ut-robotics/picr22-team-owo/electronics/pinout documentation.xlsx

Function | Timer | Channel | Pin
M1PWM | 8 | 1 | PB0
M2PWM | 8 | 2N | PA15
M3PWM | 8 | 3N | PB5
S1PWM | 15 | 1 | PA2
S2PWM | 15 | 2 | PA3
TMPWM | 2 | 1 | PA0
ENC11 | 4 | 1 | PB6
ENC12 | 4 | 2 | PB7
ENC21 | 1 | 1 | PA8
ENC22 | 1 | 2 | PA9
ENC31 | 3 | 2 | PA4
ENC32 | 3 | 1 | PA6
INFR | x |  | PF1
M1D | x | x | PA7
M2D | x | x | PA5
M3D | x | x | PB4
MSLEEP | x | x | PB3
LED1 | x | x | PF0
LED2 | x | x | PA1
