ut-robotics/picr22-team-owo/(threads)

Thread 1 (2022-09-17):

[Mechanics] Thrower walls colliding with top plate

maidlam, 2022-09-17:
The thrower walls are colliding with the top plate.

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

Closed 2022-09-18.

Thread 2 (2022-09-17):

[Mechanics] Wall wont fit between plates

maidlam, 2022-09-17:
The part of the walls that's going to be between the plates is too big - plates distance 60,4 mm, wall 61 mm.

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

Closed 2022-09-18.

Thread 3 (2022-09-17):

[Mechanics] Thrower motor too low

maidlam, 2022-09-17:
With the current height of the motor (somewhat related to issue https://github.com/ut-robotics/picr22-team-owo/issues/1), it is low enough that it may cause issues when grabbing a ball.
The motor should slightly touch the ball when driving into it - motor height of 38 mm from the floor should be enough.

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

Closed 2022-09-18.

Thread 6 (2022-09-20):

[Mechanics] Separate inner and outer contours

maidlam, 2022-09-20:
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

I mistakenly told you to also add the inner contours of the two discs to the 2D Contour operation.
Inner and outer contours should be split up into separate operations, and inner contours should be cut first.

You can create a duplicate of the current 2D Contour, only keep the inner cuts in one, and outer cuts in the other.
Then set the order of the operations under your Setup, so that the inner contour operation is before the outer contours.

Closed 2022-09-21.

Thread 7 (2022-10-05):

[Mechanics] Add support to rollers

Akustav, 2022-10-05:
You should add side supports for rollers to stop them from wibble-wobble-ing in the slot. This also allows you to make the roller slot a little larger to avoid it getting jammed with carpet fibers.

Something like this would work:
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

Closed 2022-10-28.

Thread 8 (2022-10-05):

[Mechanics] use chamfered screws for wheel mounting

Akustav, 2022-10-05:
Would you be able to use chambered screws here? This makes 3D printing simpler, allows for more material to be around the screw and results in a flush finish. Example of the holes:

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

Closed 2022-10-28.

Thread 10 (2022-10-16):

[Mechanics] interesting spacer length

Akustav, 2022-10-16:
The middle spacers are 20.40 instead of 20.00:

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

I guess this is due to material thickness and the room provided in the test chassis. It in itself is not a huge issue, just want to clarify.

Thread 11 (2022-10-16):

[Mechanics] reduce rapid distance

Akustav, 2022-10-16:
Currently the mill might cut too fast when transferring from one contour to another:

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

Check the "Keep tool down" setting and "Safe distance" to avoid such cases.

Closed 2022-10-17.

Thread 9 (2022-10-16):

[Mechanics] move thrower back a little

Akustav, 2022-10-16:
I suggest you move the thrower back a little to make room for the thrower cable. If you move everything back a little or make it shorter there is more room in point 1.

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

Closed 2022-10-17.

Thread 12 (2022-10-17):

[Mechanics] move angle adjust servo to the back

Akustav, 2022-10-17:
I suggest moving the angle adjustment servo to the back of the thrower. When it is in the front, there is a leverage disadvantage applied to the servo. This makes it harder for the servo to maintain the angle. You could for example use a sliding connection at the back:

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

Akustav, 2022-10-28:
You currently have a lot of play in the servo horn. I suggest tightening the tolerances to avoid excessive play in the adjustment ramp.

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

Akustav, 2022-10-28:
I also guess the pin is a M3 bolt? I suggest using a tapered head screw so it looks something like this:

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

I also suggest thickening up the adjustment arm on the servo. Maybe mill it from a 4.8mm piece of PC for additional rigidity.

Closed 2022-11-08.

Thread 13 (2022-10-17):

[Mechanics] roller adjustments

Akustav, 2022-10-17:
I suggest adding a lip to the roller to reduce potential side wall friction:

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

The tolerances of the servo horn area also seem too tight. Add some room there to ease assembly and disassembly:

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

Closed 2022-10-28.

Thread 15 (2022-10-17):

[Mechanics] consider adding a place for a light gate sensor

Akustav, 2022-10-17:
Currently I can not see a place for a light gate sensor. This sensor allows you to detect when a ball has been grabbed deep enough. It can be hard to detect via the camera. It can be somewhere like here (discuss in team as to where you want it to be):

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

Akustav, 2022-10-28:
Is there any way of fastening the sensor and LED? I currently see no way.

Closed 2022-11-08.

Thread 16 (2022-10-17):

[Mechanics] make thrower cable hole bigger

Akustav, 2022-10-17:
Not a big deal but I suggest making the cable hole for the thrower bigger to make cable routing simpler. The 3.5mm bullets and cables can take a lot of room and can be a pain to get through small slots.

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

Closed 2022-10-28.

Thread 20 (2022-10-26):

MCU pin assignement

ReikoR, 2022-10-26:
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

I could not find working pin usage for the MCU.

Can you explain how the timer channels are used?

Most important part is that PWM outputs can't be properly used on timers that have encoder mode enabled, as in encoder mode the counter value is changed based on encoder inputs.

dakoko, 2022-10-29:
I was unaware of the encoder mode and PWM output conflict. I changed the timers and pins around so that they'd be seperated from now on (new and old timer/pinout/channel setup is brought out in the pinout documentation spreadsheet file).

Timers 1, 3 and 4 are set to encoder mode. Timer 2 handles the thrower motor PWM, timer 8 the 3 motor PWMs and time 15 the servo PWMs.

For this fix I had to sacrifice the PWM input meant for the opto sensor and was replaced with an ADC. I will most likely handle the smoothing and other possible complications offboard.

ReikoR, 2022-10-30:
For optical sensor it's probably best to use EXTI (external interrupt) as the sensor output is digital.
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

Otherwise new pin assignment might work.

Closed 2022-10-30.

Thread 22 (2022-10-26):

Add decoupling capacitors to all MCU power pins

ReikoR, 2022-10-26:
There are currently 2 sets of decoupling capacitors:
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

But 3 power pins (2x VDD, 1x VDDA):
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

dakoko, 2022-10-29:
Added another set of decoupling capacitors for the MCU

Closed 2022-10-30.

Thread 23 (2022-10-28):

[Mechanics] why not use conical screws?

Akustav, 2022-10-28:
Is there a reason you avoid conical screws? They tend to weaken the components less when attaching them. They just need some countersinking to work. We have a specific drill for that. Number one is the conical counter sink, compared to approach on number 2.

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

Closed 2022-11-08.

Thread 24 (2022-10-28):

[Mechanics] move spacers in for ramp

Akustav, 2022-10-28:
I suggest moving the spacer for the internal ramp a little forward or replace one spacer with two. Since the ramp is quite long, it can bend and increase variation in ball grabbing:

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

Closed 2022-11-08.

Thread 25 (2022-10-30):

Overlapping schematic objects

ReikoR, 2022-10-30:
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

dakoko, 2022-10-31:
Fixed the overlap on the schematic

ReikoR, 2022-11-02:
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

dakoko, 2022-11-02:
Fixed the overlap for c14

Closed 2022-11-06.

Thread 27 (2022-10-30):

Incorrect isolator pinout

ReikoR, 2022-10-30:
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

Right side pin numbers are in reverse order.

Correct pinout:
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

dakoko, 2022-10-31:
Fixed the isolator pinout and rerouted things accordingly

ReikoR, 2022-11-06:
Some pins are still incorrect:
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

dakoko, 2022-11-06:
Fixed the power pin order.

Closed 2022-11-09.

Thread 28 (2022-10-30):

DRVOFF does not need to be connected to MCU

ReikoR, 2022-10-30:
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

DRVOFF can be connected to GND to keep motor driver constantly enabled.

This would allow to free up one isolator pin and allow to use smaller 2-channel isolator.

dakoko, 2022-10-31:
Removed the DRVOFF pin connections, however I still argue for having 3 4-channel isolators as three of the outputs are needed at the top of the board. Replacing it with a 2 channel isolator would needlessly lengthen the signal traces (and also cut into the copperless area inbetween the isolated grounds).

Closed 2022-11-09.

Thread 30 (2022-11-05):

[Mechanics] Camera mount issues

maidlam, 2022-11-05:
1. Add bolts to both sides of the middle support.
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

2. Add bolts to both sides of the camera mount crossbeam.
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

3. Faulty tenon for camera mount and bottom plate.
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

Closed 2022-11-16.

Thread 32 (2022-11-06):

PA1 pin used for ball sensor is not 5V tolerant

ReikoR, 2022-11-06:
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

From [datasheet](https://www.st.com/resource/en/datasheet/stm32g441kb.pdf):
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

dakoko, 2022-11-06:
The output signal of the ball sensor is going to be brought down to 3.3v with the offboard electronics needed for the sensor. Most likely through a voltage divider.

ReikoR, 2022-11-06:
It would be easier to use one of the 5V tolerant pins. For example PF0 or PF1:
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

dakoko, 2022-11-06:
Switched the signal led pin (PF1) with the ball sensor pin (PA1)

Thread 34 (2022-11-06):

Use wider motor driver output connections

ReikoR, 2022-11-06:
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

Polygons can be used:
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

Pads could also be placed right next to the drivers:
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

dakoko, 2022-11-06:
Placed the pads next to the drivers and rerouted traces to create less dead copper.

Closed 2022-11-09.

Thread 36 (2022-11-09):

Avoid routing tracks next to each other

ReikoR, 2022-11-09:
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

Signals from one track will couple into adjacent tracks and cause noise.

dakoko, 2022-11-09:
Dismantled the buses, most have significantly more room between them now.

ReikoR, 2022-11-09:
Still some improvements that could be made:

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

dakoko, 2022-11-10:
Followed the suggested improvements.

Closed 2022-11-10.

Thread 37 (2022-11-09):

Place GND vias close to components

ReikoR, 2022-11-09:
For example:
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

dakoko, 2022-11-09:
Added lots of vias.

ReikoR, 2022-11-09:
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

dakoko, 2022-11-09:
Suggested locations are directly above 2 power rails, is it really worth putting a hole through VBAT?
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

ReikoR, 2022-11-10:
5V track can be moved. Having it next to VBAT is not good anyway.

Something like this:
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

dakoko, 2022-11-10:
Moved the trace

Closed 2022-11-10.

Thread 38 (2022-11-09):

LEDs at the bottom

ReikoR, 2022-11-09:
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

Not sure how you will attach the PCB to the robot, but LEDs might not be visible on the robot or even off the robot.

dakoko, 2022-11-09:
These LEDs will be used for firmware debugging with an open robot where the PCB isn't attached.

Closed 2022-11-09.

Thread 39 (2022-11-09):

Route USB data signals as differential pair

ReikoR, 2022-11-09:
More information here:
https://github.com/ut-robotics/picr22-team-gibibot/issues/32

But use JLC7628 stackup as it is cheaper.

For example 8 mil (about 0.2 mm) trace space and 10.28 mil (about 0.26 mm) trace width would work:
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

dakoko, 2022-11-10:
Rerouted the USB data signals to comply with these rules

Closed 2022-11-10.

Thread 40 (2022-11-09):

Create Gerber X2 files

ReikoR, 2022-11-09:
Create Gerber X2 layer and drill files and commit them to repository for ordering the manufacturing.

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

dakoko, 2022-11-10:
Added the gerber files

dakoko, 2022-11-10:
Added the updated files

ReikoR, 2022-11-10:
Add *.gbr files also.

dakoko, 2022-11-11:
Added the gerber files, i didn't notice that the output folder wasn't included

dakoko, 2022-11-11:
Added fresh files

Closed 2022-11-11.

Thread 41 (2022-11-09):

Improve switching regulator layout

ReikoR, 2022-11-09:
Try to follow guidelines in the [TPS62933 datasheet](https://www.ti.com/lit/ds/symlink/tps62933.pdf) under 12.1 Layout Guidelines.

1. C6 capacitor should be at the output:
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

2. VIN and GND connections should be wider and with more vias.
\
From datasheet:
The VIN and GND traces must be as wide as possible and provide sufficient vias on them to minimize trace impedance. The wide areas are also of advantage from the view point of heat dissipation.
\
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

3. SW connection should be wider.
\
From datasheet:
Keep the SW trace as physically short and wide as practical to minimize radiated emissions.
\
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

4. Route feedback trace further away from the switching trace. In the current layout it's hard to route it through bottom layer, but it can be routed a bit farther from the inductor. It should also connect to output capacitors.
\
From datasheet:
Place the voltage feedback loop away from the high-voltage switching trace. The voltage feedback loop preferably has ground shield.
\
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

dakoko, 2022-11-10:
Alleviated the issues, don't know if it's enough though.

ReikoR, 2022-11-10:
It's possible to make SW copper a bit wider by moving the regulator downwards.

Before:
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

After:
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

I recommend using Polygon Pour instead of Region. Polygons automatically pour based on the rules.

Polygons:
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

Regulator input GND polygon properties:
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

I created a Polygon Connect Style rule to use direct connection for these polygons:
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
`InNet('NetC13_1') or InNet('VBAT') or ((ObjectKind = 'Poly') And (Name = 'GND_SWREG_IN')) `

Pour order also needs to be changed in Polygon Manager (Tools -> Polygon Pours -> Polygon Manager):
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
Smaller polygons need to poured before larger GND polygon.

dakoko, 2022-11-10:
Replaced the regions with pours

ReikoR, 2022-11-10:
There are very thin gaps next to the GND polygon:
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

dakoko, 2022-11-11:
Added thermal relief and fixed the thin gap issue

ReikoR, 2022-11-11:
It would be better to have GND directly connected.

dakoko, 2022-11-11:
Connected it directly

Closed 2022-11-11.

Thread 45 (2022-11-13):

[Mechanics] Tight area for step up converter cables

Akustav, 2022-11-13:
There seems to be not too much room for the throwers step up converter cabling. Is this intentional?

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

Closed 2022-11-16.

Thread 46 (2022-11-13):

[Mechanics] camera mount interlocks with top plate

Akustav, 2022-11-13:
A question about the top plate - camera mount interface.

Why should they lock in with each other? Would it not increase assembly complexity by a lot? Are there any benefits to doing it compared to not doing it?

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

Rxsengxn, 2022-11-17:
Yes it does increase assembly complexity but not that much. During first assembly, it is needed to slide them through top plate and lock them, that's all the increased complexity. After the assembly, when it's needed to get inside the robot, only the bottom plate camera mount screws need to be unscrewed in addition to other common part's screws for it to come off.

Closed 2022-11-19.

Thread 48 (2022-11-13):

[Mechanics] suggest hollowing out some of the "Kate" elements

Akustav, 2022-11-13:
I suggest to hollow out some elements of the component "Kate" so it has some room to deform when you push it in. Something like this maybe:

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

maidlam, 2022-11-16:
I think Allan meant you leave the sides intact, but cut out the center, so the sides deform inward when the part is pressed in - a reverse of the current part.
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

Thread 49 (2022-11-13):

[Mechanics] different screw holes

Akustav, 2022-11-13:
Is it intentional to have different hole styles in the same area?

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

Akustav, 2022-11-13:
Same here:

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

Rxsengxn, 2022-11-17:
These are somewhat intentional, yes. In general we used cone-shaped screws where really needed, and cylinder, where it doesn't matter that much. We could make them all cones if needed

Closed 2022-11-19.
