ut-robotics/picr22-team-owo/electronics/picr22-team-owo-mainboard/picr22-team-owo-mainboard.pdf

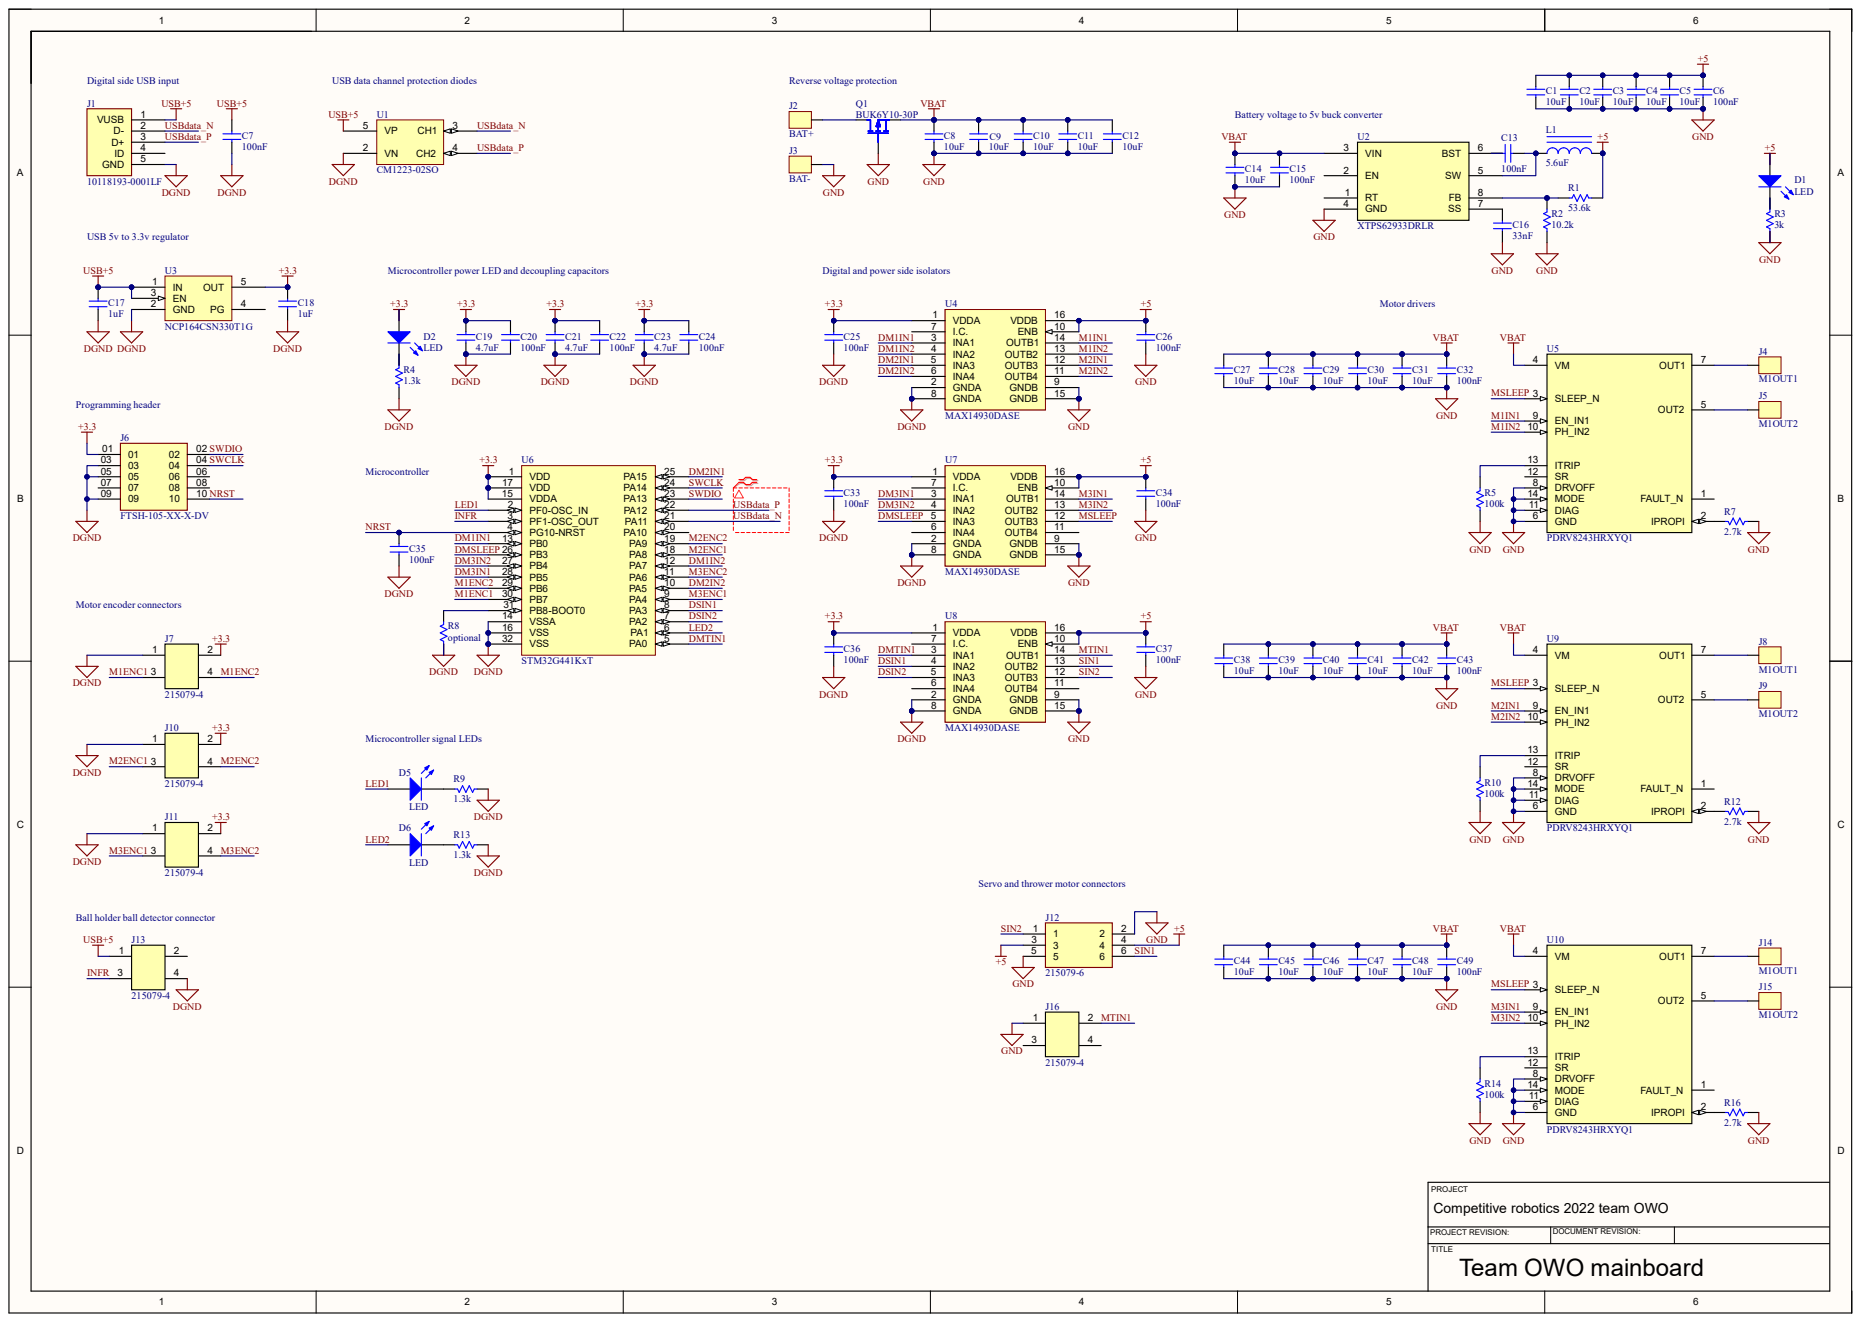
[picture p11: page 1]

Digital side USB input

USB data channel protection diodes

Battery voltage to 5v buck converter

Microcontroller power LED and decoupling capacitors

Digital and power side isolators

Servo and thrower motor connectors

Ball holder ball detector connector

PROJECT
Competitive robotics 2022 team OWO
