ut-robotics/picr22-team-owo/(list of files, drawings)

Other design files:
electronics/picr22-team-owo-mainboard/picr22-team-owo-mainboard-lib.PcbLib
electronics/picr22-team-owo-mainboard/picr22-team-owo-mainboard-lib.SchLib
electronics/picr22-team-owo-mainboard/picr22-team-owo-mainboard.PcbDoc
electronics/picr22-team-owo-mainboard/picr22-team-owo-mainboard.PrjPcb
electronics/picr22-team-owo-mainboard/picr22-team-owo-mainboard.SchDoc
