ut-robotics/picr22-team-owo/firmware/picr22-team-OWO/picr22-team-OWO.ioc

Mcu.UserName=STM32G441KBTx
PA0.GPIO_Label=TMPWM
PA0.Signal=S_TIM2_CH1
PA1.GPIO_Label=LED2
PA1.Signal=GPIO_Output
PA11.Signal=USB_DM
PA12.Signal=USB_DP
PA13.Signal=SYS_JTMS-SWDIO
PA14.Signal=SYS_JTCK-SWCLK
PA15.GPIO_Label=M2PWM
PA15.Signal=S_TIM8_CH1
PA2.GPIO_Label=S1PWM
PA2.Signal=S_TIM15_CH1
PA3.GPIO_Label=S2PWM
PA3.Signal=S_TIM15_CH2
PA4.GPIO_Label=ENC31
PA4.Signal=S_TIM3_CH2
PA5.GPIO_Label=M2D
PA5.Signal=GPIO_Output
PA6.GPIO_Label=ENC32
PA6.Signal=S_TIM3_CH1
PA7.GPIO_Label=M1D
PA7.Signal=GPIO_Output
PA8.GPIO_Label=ENC21
PA8.Signal=S_TIM1_CH1
PA9.GPIO_Label=ENC22
PA9.Signal=S_TIM1_CH2
PB0.GPIO_Label=M1PWM
PB0.Signal=TIM8_CH2N
PB3.GPIO_Label=MSLEEP
PB3.Signal=GPIO_Output
PB4.GPIO_Label=M3D
PB4.Signal=GPIO_Output
PB5.GPIO_Label=M3PWM
PB5.Signal=TIM8_CH3N
PB6.GPIO_Label=ENC11
PB6.Signal=S_TIM4_CH1
PB7.GPIO_Label=ENC12
PB7.Signal=S_TIM4_CH2
PF0-OSC_IN.GPIO_Label=LED1
PF0-OSC_IN.Signal=GPIO_Output
PF1-OSC_OUT.GPIO_Label=INFR
PF1-OSC_OUT.Signal=GPIO_Input
