ut-robotics/picr22-team-owo/firmware/picr22-team-OWO/Core/Src/main.c

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
/* Includes ------------------------------------------------------------------*/
#include "main.h"
#include "usb_device.h"

/* USER CODE BEGIN Includes */
#include "usbd_cdc_if.h" // (1)
/* USER CODE END Includes */

TIM_HandleTypeDef htim1;
TIM_HandleTypeDef htim2;
TIM_HandleTypeDef htim3;
TIM_HandleTypeDef htim4;
TIM_HandleTypeDef htim6;
TIM_HandleTypeDef htim8;
TIM_HandleTypeDef htim15;

void SystemClock_Config(void);
static void MX_GPIO_Init(void);
static void MX_TIM2_Init(void);
static void MX_TIM3_Init(void);
static void MX_TIM1_Init(void);
static void MX_TIM4_Init(void);
static void MX_TIM8_Init(void);
static void MX_TIM15_Init(void);
static void MX_TIM6_Init(void);
/* USER CODE BEGIN 0 */
typedef struct Motor_Status {
	uint16_t target_speed; // in encoder units
	uint8_t direction; // 1 = forward, 0 = backward
	int16_t enc_pos; // current encoder position
	int16_t enc_change; // Change of the encoder, currently used for debugging purposes
	int16_t integral; // PID stuff borrowed from kurgimopeed
	int16_t flat_const;
	int16_t int_const;
	int16_t der_const;
	int16_t error;
} Motor_Status;

typedef struct Command {
  int16_t speed[3]; // array of all of the motor speeds, CURRENTLY int16_t DUE TO TESTING WITH RAW MOTOR VALUES, MOVE BACK TO int8_t
  uint16_t thrower_speed; // thrower motor speed
  uint16_t servo1;
  uint16_t servo2;
  int16_t int_const;
  int16_t flat_const;
  int16_t der_const;
  uint16_t delimiter;
} Command;

typedef struct Feedback {
  int16_t speed[3];
  int16_t change[3];
  int16_t error[3];
  int16_t integral[3];
  uint16_t ball_detected;
} Feedback;

// Motor structs for all 3 motors
Motor_Status motor_status[3] = {0};

// Prefilled command struct
Command command = {.speed[0] = 0,
				   .speed[1] = 0,
				   .speed[2] = 0,
				   .thrower_speed = 3277,
				   .servo1 = 4875,
				   .servo2 = 6150,
				   .flat_const = 1,
				   .int_const = 0.1,
				   .delimiter = 0};

volatile uint8_t isCommandReceived = 0;
volatile uint16_t commandless_count = 0;

uint16_t clamp_u16(uint16_t value, uint16_t min, uint16_t max) {
	if (value > max) {return max;}
	else if (value < min) {return min;}
	return value;
}

int16_t clamp_16(int16_t value, int16_t min, int16_t max) {
	if (value > max) {return max;}
	else if (value < min) {return min;}
	return value;
}

int32_t clamp_32(int32_t value, int32_t min, int32_t max) {
	if (value > max) {return max;}
	else if (value < min) {return min;}
	return value;
}


// Copies the recieved command into the command struct
void CDC_On_Receive(uint8_t* buffer, uint32_t* length) { // command recieve callback, copies data to command struct
  if (*length == sizeof(Command)) {
    memcpy(&command, buffer, sizeof(Command));
    if (command.delimiter == 0xAAAA) {
      isCommandReceived = 1;
      commandless_count = 0;
    }
  }
}

// Initialises the encoders
void enc_init() {
	HAL_TIM_Encoder_Start(&htim4, TIM_CHANNEL_1 | TIM_CHANNEL_2); // Motor 1 ?
	HAL_TIM_Encoder_Start(&htim1, TIM_CHANNEL_1 | TIM_CHANNEL_2); // Motor 2
	HAL_TIM_Encoder_Start(&htim3, TIM_CHANNEL_1 | TIM_CHANNEL_2); // Motor 3 ?
}

// Initialises the PWMs
void pwm_init() {
	TIM8->CCR2 = 0;
	TIM8->CCR1 = 0;
	TIM8->CCR3 = 0;

	TIM2->CCR1 = 4915;

	TIM15->CCR1 = 4875;
	TIM15->CCR2 = 6150;

    HAL_TIM_PWM_Start(&htim8, TIM_CHANNEL_1);
    HAL_TIMEx_PWMN_Start(&htim8, TIM_CHANNEL_2);
    HAL_TIMEx_PWMN_Start(&htim8, TIM_CHANNEL_3);

    HAL_TIM_PWM_Start(&htim2, TIM_CHANNEL_1);

    HAL_TIM_PWM_Start(&htim15, TIM_CHANNEL_1);
    HAL_TIM_PWM_Start(&htim15, TIM_CHANNEL_2);
}

// Updates the motor's speed, direction and PI constants from the command struct
void motor_status_update() {
	for (uint8_t i = 0; i<3; i++) {
		motor_status[i].target_speed = command.speed[i];
		motor_status[i].flat_const = command.flat_const;
		motor_status[i].int_const = command.int_const;
		motor_status[i].der_const = command.der_const;
	}
}

// Converts internal encoder speed to a PWM value
uint16_t motor_pwm(uint8_t m_id) {
    // For ease of use
    Motor_Status m =  motor_status[m_id];

    // Get new position of the encoder, currently a bit hacky due to motors 1 and 3 flipping the enc movement for some reason
	uint16_t new_pos = 0;
	int16_t pos_change = 0;
    switch (m_id) {
		case 0:
			new_pos = TIM3->CNT;
			pos_change = -((int16_t)new_pos - m.enc_pos);
			break;
		case 1:
			new_pos = TIM1->CNT;
			pos_change = (int16_t)new_pos - m.enc_pos;
			break;
		case 2:
			new_pos = TIM4->CNT;
			pos_change = -(((int16_t)new_pos) - m.enc_pos);
			break;
	}

	// Clear PI-s integral value when the bot is ordered to stop, might cause issues down the line
	if (motor_status[0].target_speed == 0 && motor_status[1].target_speed == 0 && motor_status[2].target_speed == 0) {
		m.integral = 0;
	}

	m.error = m.target_speed - pos_change;
	m.integral = clamp_16(m.integral + m.error, -4096, 4096);

	int32_t pwm = ((int32_t) m.error * (int32_t) m.flat_const) +
                  ((int32_t) m.integral * (int32_t) m.int_const) +
                  ((int32_t) (pos_change - m.enc_change) * (int32_t) m.der_const);

	if (pwm < 0) {m.direction = 0;}
	else {m.direction = 1;}

    m.enc_pos = new_pos;
	m.enc_change = pos_change;
	motor_status[m_id] = m;

	pwm = clamp_32(abs(pwm), 0, 65534);

	return (uint16_t) pwm;
}

// Toggles the direction pin
void motor_direction(uint8_t mot_id) {
	switch(mot_id) {
		case 0:
			HAL_GPIO_WritePin(GPIOA, M1D_Pin, motor_status[0].direction);
			break;
		case 1:
			HAL_GPIO_WritePin(GPIOA, M2D_Pin, motor_status[1].direction);
			break;
		case 2:
			HAL_GPIO_WritePin(GPIOB, M3D_Pin, motor_status[2].direction);
			break;
	}
}

// Sends a very short ground pulse to the sleep pin of the motor controllers
void wake_drivers_up() {
	HAL_GPIO_WritePin(GPIOB, MSLEEP_Pin, GPIO_PIN_SET);
	for(uint16_t i = 0; i < 350; i++) __asm("nop");
	HAL_GPIO_WritePin(GPIOB, MSLEEP_Pin, GPIO_PIN_RESET);
	for(uint16_t i = 0; i < 350; i++) __asm("nop");
	HAL_GPIO_WritePin(GPIOB, MSLEEP_Pin, GPIO_PIN_SET);
}
// Currently abandoned.

// 50 Hz callback
void HAL_TIM_PeriodElapsedCallback(TIM_HandleTypeDef *htim) {
	if (commandless_count >= 50) { // Helps prevent major consequences from minor fuckups
		TIM8->CCR2 = 0;
		TIM8->CCR2 = 0;
		TIM8->CCR2 = 0;
		TIM2->CCR1 = 3277;
		TIM15->CCR1 = 4875;
		return;
	}

	TIM8->CCR2 = motor_pwm(0); // Motor 1
	TIM8->CCR1 = motor_pwm(1); // Motor 2
	TIM8->CCR3 = motor_pwm(2); // Motor 3

	motor_direction(0); // Motor 1
	motor_direction(1); // Motor 2
	motor_direction(2); // Motor 3

	TIM2->CCR1 = clamp_u16(command.thrower_speed, 3277, 6554);

	TIM15->CCR1 = clamp_u16(command.servo1, 3277, 6554);
	TIM15->CCR2 = clamp_u16(command.servo2, 4700, 6150);

	commandless_count++;
}
/* USER CODE END 0 */

/**
  * @brief  The application entry point.
  * @retval int
  */
int main(void)
{
  /* MCU Configuration--------------------------------------------------------*/

  /* Reset of all peripherals, Initializes the Flash interface and the Systick. */
  HAL_Init();

  /* Configure the system clock */
  SystemClock_Config();

  /* Initialize all configured peripherals */
  MX_GPIO_Init();
  MX_TIM2_Init();
  MX_TIM3_Init();
  MX_TIM1_Init();
  MX_TIM4_Init();
  MX_TIM8_Init();
  MX_TIM15_Init();
  MX_TIM6_Init();
  MX_USB_Device_Init();
  /* USER CODE BEGIN 2 */
  Feedback feedback = {
	    .speed[0] = 0,
	    .speed[1] = 0,
	    .speed[2] = 0,
		.change[0] = 0,
		.change[1] = 0,
		.change[2] = 0,
		.ball_detected = 0,
  };
  HAL_TIM_Base_Start_IT(&htim6);
  HAL_Delay(100);
  enc_init();
  pwm_init();
  wake_drivers_up();

  /* USER CODE END 2 */

  /* Infinite loop */
  /* USER CODE BEGIN WHILE */
  while (1)
  {
    if (isCommandReceived) {
    	isCommandReceived = 0;

    	wake_drivers_up();
    	motor_status_update();

    	for (int i = 0; i < 3; i++) {
			feedback.speed[i] = motor_status[i].target_speed;
			feedback.change[i] = motor_status[i].enc_change;
			feedback.error[i] = motor_status[i].error;
			feedback.integral[i] = motor_status[i].integral;
    	}
		feedback.ball_detected = HAL_GPIO_ReadPin (INFR_GPIO_Port, INFR_Pin);

		CDC_Transmit_FS(&feedback, sizeof(feedback));
	}
    /* USER CODE END WHILE */

    /* USER CODE BEGIN 3 */
  }
  /* USER CODE END 3 */
}

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
