ut-robotics/picr22-team-owo/firmware/picr22-team-OWO/Core/Inc/main.h

#define LED1_Pin GPIO_PIN_0
#define LED1_GPIO_Port GPIOF
#define INFR_Pin GPIO_PIN_1
#define INFR_GPIO_Port GPIOF
#define TMPWM_Pin GPIO_PIN_0
#define TMPWM_GPIO_Port GPIOA
#define LED2_Pin GPIO_PIN_1
#define LED2_GPIO_Port GPIOA
#define S1PWM_Pin GPIO_PIN_2
#define S1PWM_GPIO_Port GPIOA
#define S2PWM_Pin GPIO_PIN_3
#define S2PWM_GPIO_Port GPIOA
#define ENC31_Pin GPIO_PIN_4
#define ENC31_GPIO_Port GPIOA
#define M2D_Pin GPIO_PIN_5
#define M2D_GPIO_Port GPIOA
#define ENC32_Pin GPIO_PIN_6
#define ENC32_GPIO_Port GPIOA
#define M1D_Pin GPIO_PIN_7
#define M1D_GPIO_Port GPIOA
#define M1PWM_Pin GPIO_PIN_0
#define M1PWM_GPIO_Port GPIOB
#define ENC21_Pin GPIO_PIN_8
#define ENC21_GPIO_Port GPIOA
#define ENC22_Pin GPIO_PIN_9
#define ENC22_GPIO_Port GPIOA
#define M2PWM_Pin GPIO_PIN_15
#define M2PWM_GPIO_Port GPIOA
#define MSLEEP_Pin GPIO_PIN_3
#define MSLEEP_GPIO_Port GPIOB
#define M3D_Pin GPIO_PIN_4
#define M3D_GPIO_Port GPIOB
#define M3PWM_Pin GPIO_PIN_5
#define M3PWM_GPIO_Port GPIOB
#define ENC11_Pin GPIO_PIN_6
#define ENC11_GPIO_Port GPIOB
#define ENC12_Pin GPIO_PIN_7
#define ENC12_GPIO_Port GPIOB
