ut-robotics/picr22-team-owo/(commit log)

2022-09-19 changed stuff in imageproc code, hopefully correct disance
    [camera.py, image_processor.py]
2022-09-22 currently in the middle of getting the average over lines....
2022-09-26 Orbiting fixes and testing on robot
    [main.py, robot_utilities.py]
2022-10-03 Added sigmoid controller, small bugfixes
    [main.py, robot_utilities.py]
2022-10-03 Sigmoid and orbiting bugfixes
    [main.py]
2022-10-05 Created a most of the components and added some of the schematic
    [picr22-team-owo-mainboard-lib.PcbLib, picr22-team-owo-mainboard-lib.SchLib, picr22-team-owo-mainboard.PcbDoc, picr22-team-owo-mainboard.PrjPcb, picr22-team-owo-mainboard.SchDoc]
2022-10-06 Thrower calibration
2022-10-06 Thrower calibration fixes
2022-10-09 Progress from yesterday
    [picr22-team-owo-mainboard-lib.PcbLib, picr22-team-owo-mainboard-lib.SchLib, picr22-team-owo-mainboard.PcbDoc, picr22-team-owo-mainboard.SchDoc]
2022-10-16 Full schematic design, still missing capacitor footprint
    [picr22-team-owo-mainboard-lib.PcbLib, picr22-team-owo-mainboard-lib.SchLib, picr22-team-owo-mainboard.PcbDoc, picr22-team-owo-mainboard.PrjPcb, picr22-team-owo-mainboard.SchDoc]
2022-10-17 misc fixes changes etc tere
    [camera.py, image_processor.py, main.py]
2022-10-17 Improved missing array handling
    [camera.py, image_processor.py, main.py]
2022-10-23 Essencially complete schematic, WIP. board layout and routing
    [picr22-team-owo-mainboard-lib.PcbLib, picr22-team-owo-mainboard-lib.SchLib, picr22-team-owo-mainboard.PcbDoc, picr22-team-owo-mainboard.PrjPcb, picr22-team-owo-mainboard.SchDoc, pinout documentation.xlsx]
2022-10-29 Drew most of the traces, fixed a few bugs. Timers still broken
    [picr22-team-owo-mainboard.PcbDoc, picr22-team-owo-mainboard.PrjPcb, picr22-team-owo-mainboard.SchDoc, pinout documentation.xlsx]
2022-10-29 Fixed the timer issues (I think)
    [picr22-team-owo-mainboard.PcbDoc, picr22-team-owo-mainboard.SchDoc, pinout documentation.xlsx]
2022-10-31 Fixed listed problems, routed power rails, vias currently WIP
    [picr22-team-owo-mainboard-lib.SchLib, picr22-team-owo-mainboard.PcbDoc, picr22-team-owo-mainboard.PrjPcb, picr22-team-owo-mainboard.SchDoc, pinout documentation.xlsx]
2022-11-02 Fixed text overlap
    [picr22-team-owo-mainboard.PcbDoc, picr22-team-owo-mainboard.SchDoc]
2022-11-05 Fixed a few issues, poured ground polygons, plane stitching WIP
    [picr22-team-owo-mainboard.PcbDoc]
2022-11-06 lines.. calibration.... ball......
2022-11-06 Fixed the listed problems, middle 2 planes and reorgnaised traces to create less dead copper.
    [picr22-team-owo-mainboard-lib.SchLib, picr22-team-owo-mainboard.PcbDoc, picr22-team-owo-mainboard.SchDoc, pinout documentation.xlsx]
2022-11-07 Fixed few minor issues
    [picr22-team-owo-mainboard-lib.PcbLib, picr22-team-owo-mainboard-lib.SchLib, picr22-team-owo-mainboard.PcbDoc, picr22-team-owo-mainboard.SchDoc]
2022-11-09 Accelration limiter and other minor fixes
    [image_processor.py, main.py, mainboard.py, robot_utilities.py]
2022-11-09 More minor fixes before test competition
    [main.py, mainboard.py, robot_utilities.py]
2022-11-09 Dismantled buses, added lots of vias
    [picr22-team-owo-mainboard.PcbDoc]
2022-11-09 Added one more via to the ground pad :D
    [picr22-team-owo-mainboard.PcbDoc]
2022-11-09 Added two more vias to a pad!
    [picr22-team-owo-mainboard.PcbDoc]
2022-11-10 Fixed a large bunch of issues, whether these are enough is unknown
    [picr22-team-owo-mainboard.PcbDoc, picr22-team-owo-mainboard.SchDoc]
2022-11-10 Added Gerber x2 layer and drill files
    [picr22-team-owo-mainboard.PcbDoc]
2022-11-10 Forgot to add the drill files
2022-11-10 Did not follow the guide properly, redid the gerber file
2022-11-10 I forgot to update the projectfile
    [picr22-team-owo-mainboard.PrjPcb]
2022-11-10 Replaced regions with pours and moved 5v
    [picr22-team-owo-mainboard.PcbDoc, picr22-team-owo-mainboard.PrjPcb]
2022-11-10 Added signature and team name
    [picr22-team-owo-mainboard.PcbDoc]
2022-11-10 Forgot to update project file
    [picr22-team-owo-mainboard.PrjPcb]
2022-11-11 fixed issue with polygon, added thermal relief
    [picr22-team-owo-mainboard.PcbDoc, picr22-team-owo-mainboard.PrjPcb]
2022-11-11 Actually added the gerber files this time
    [picr22-team-owo-mainboard_Copper_Signal_1.gbr, picr22-team-owo-mainboard_Copper_Signal_2.gbr, picr22-team-owo-mainboard_Copper_Signal_Bot.gbr, picr22-team-owo-mainboard_Copper_Signal_Top.gbr, picr22-team-owo-mainboard_Legend_Bot.gbr, picr22-team-owo-mainboard_Legend_Top.gbr, picr22-team-owo-mainboard_NPTH_Drill.gbr, picr22-team-owo-mainboard_PTH_Drill.gbr]
2022-11-11 Fixed tiny issue, updated grb files
    [picr22-team-owo-mainboard.PcbDoc, picr22-team-owo-mainboard.PrjPcb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]
2022-11-28 Moved firmware folder to proper location
    [picr22-team-owo-mainboard.PcbDoc]
2022-12-05 MINOR: Fixed a state name
    [main.py]
2022-12-06 PI feedback for the motors and other stuff
2022-12-06 Fixed devious PI controller bug, added DSHOT150
    [main.c, picr22-team-OWO.ioc, usb_debug.py]
2022-12-08 Moved over from 100Hz to 50Hz
2022-12-13 PI calibration
2022-12-14 Minor improvements and D in PID
2022-12-15 Significantly improved pid
2023-01-15 Added logic flowchart
2023-01-17 Ordered gerber file around
    [picr22-team-owo-mainboard_Copper_Signal_1.gbr, picr22-team-owo-mainboard_Copper_Signal_2.gbr, picr22-team-owo-mainboard_Copper_Signal_Bot.gbr, picr22-team-owo-mainboard_Copper_Signal_Top.gbr, picr22-team-owo-mainboard_Legend_Bot.gbr, picr22-team-owo-mainboard_Legend_Top.gbr, picr22-team-owo-mainboard_NPTH_Drill.gbr, picr22-team-owo-mainboard_PTH_Drill.gbr]
2023-01-17 Funny that i need to give order codes for stuff that i didnt even order
    [picr22-team-owo-mainboard.tsv]
2023-01-17 renamed excel file
    [old_pinout_docs.xlsx]
2023-01-18 Fixed broken order codes
    [picr22-team-owo-BOM.tsv]
