ut-robotics/picr22-team-owo/(notices)

Notices in the files:
firmware/picr22-team-OWO/Core/Src/main.c:
Copyright (c) 2022 STMicroelectronics.
All rights reserved.
This software is licensed under terms that can be found in the LICENSE file
